Estebge/Systeme-embarque/pictures/uml-cas-utilisation-1.png

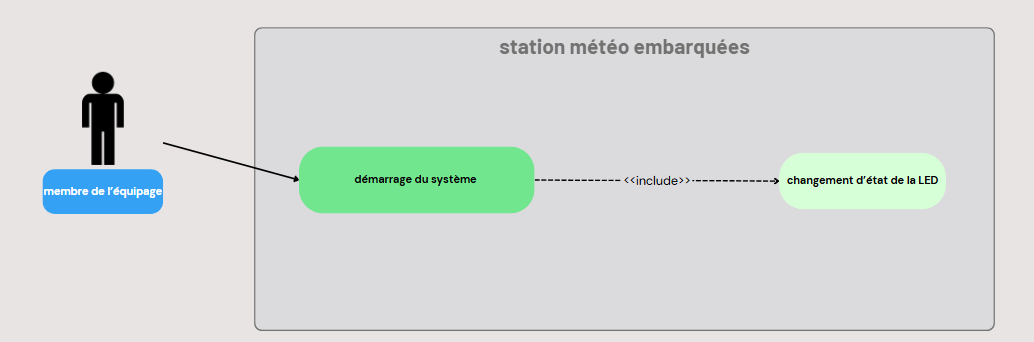
pictures/uml-cas-utilisation-1.png
