Estebge/Systeme-embarque/pictures/uml-cas-utilisation-2.png

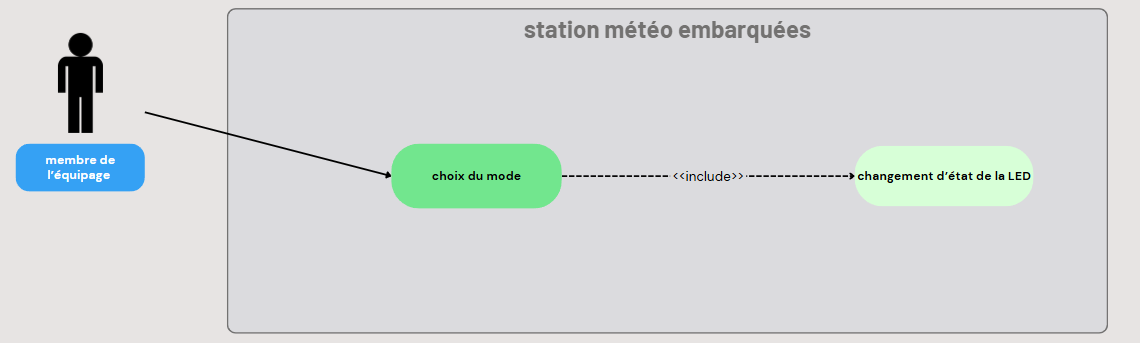
pictures/uml-cas-utilisation-2.png
